kalariya-nikunj/Vishwakarma-Awards-KneeSense/media/photos/README.md

# Prototype photos

Photos are hosted in the project owner's [Google Drive media folder](https://drive.google.com/drive/folders/1JCOzSr-7obGCgrjGczuZRWfTyBF06cKV?usp=sharing).

Media stays in Drive rather than Git history. Folder contents and viewer access have not been verified. Check the link in a signed-out browser before sharing with judges; no sharing permissions were changed during repository setup. Add direct photo links and captions here when selected.
