kalariya-nikunj/Vishwakarma-Awards-KneeSense/hardware/KiCad/Prototype_KneeSense_V1/KneeSense_Bill_of_Materials-1.xlsx

Sheet: BOM
KneeSense — Bill of Materials (BOM)
Portable knee-movement assessment system | Estimated India retail prices (₹), checked Oct 2026; confirm before purchase
Item ID | Category | Component / Material | Specification / Part | Qty per Node | Qty for 2 Nodes | Unit | Purpose / Notes | Unit Cost (₹) | Total Cost (₹) | Supplier / Link | Status
KS-001 | Electronics | Microcontroller (MCU) | Seeed XIAO nRF52840 Sense | 1 | 2 | piece | Main MCU and Bluetooth Low Energy (BLE) communication | ₹2300.00 |  |  | Selected in project deck
KS-002 | Electronics | IMU Sensor | Integrated 6-axis IMU (accelerometer + gyroscope) | 1 | 2 | piece | Movement sensing; the deck also lists magnetometer in the BOM description | ₹0.00 |  |  | Selected in project deck
KS-003 | Electronics | Micro SD Card Module | Micro SD module | 1 | 2 | piece | Local data storage / gait data | ₹89.00 |  |  | Listed in project deck
KS-004 | Electronics | Button (Tactile Switch) | Momentary push button | 1 | 2 | piece | User input / start-stop recording | ₹4.00 |  |  | Listed in project deck
KS-005 | Power | Battery | Li-Po, 3.7 V, approximately 500 mAh | 1 | 2 | piece | Portable power supply | ₹177.00 |  |  | Listed in project deck
KS-006 | Power | Voltage Regulator | 3.3 V input/output; optional | 1 | 2 | piece | Stable power for MCU and sensors; confirm whether needed for selected battery/board | ₹40.00 |  |  | Optional / verify
KS-007 | Connections | Connectors / Headers | Pin headers, JST connectors as required |  |  | lot | Sensor and battery connections; quantities depend on PCB layout | ₹100.00 | ₹100.00 |  | As required
KS-008 | Support | Miscellaneous Electronics | Resistors, capacitors, LEDs (optional) |  |  | lot | Supporting circuitry and indicators | ₹100.00 | ₹100.00 |  | Optional / as required
 |  |  |  |  |  |  |  | Estimated Total
Quantity note: | The project deck describes two wearable IMU nodes (thigh + shank). Qty for 2 nodes is calculated for fixed per-node quantities; items marked 'as required' need final PCB/wiring confirmation.

Sheet: Fabrication
KneeSense — Fabrication & Assembly Materials
Materials listed on page 9 of the supplied project deck. Quantities and costs were not specified in the source.
Item ID | Item | Specification | Purpose | Estimated Quantity | Unit Cost (₹) | Notes
KS-F01 | Copper Plate / PCB | Custom PCB with copper layer | Circuit board fabrication |  | ₹250.00 | Budget estimate; PCB fabrication price depends on size and quantity
KS-F02 | Soldering Iron | Temperature-controlled; approximately 25–60 W | Soldering components |  | ₹500.00 | Approximate shared tool cost; exclude if already available
KS-F03 | Solder Wire | Lead-free solder wire, e.g. Sn-Ag-Cu | Electrical connections |  | ₹150.00 | Estimated solder wire spool
KS-F04 | Connecting Wire | Jumper wires / hookup wire | Interconnections between modules |  | ₹100.00 | Estimated jumper/hookup wire allowance
KS-F05 | Miscellaneous Fabrication Supplies | Flux, PCB drill (if needed), etc. | Supporting fabrication |  | ₹150.00 | Estimated consumables allowance
 |  |  |  | Estimated subtotal

Sheet: README
KneeSense BOM — README
Project | KneeSense — A Portable System for Knee-Movement Assessment and Longitudinal Monitoring Research
Application ID | VK26-IITI-HT-0186
Source file | Vishwakarma Round 2 (1).pdf, especially page 9: Electronics Schematics & Bill of Materials
Node configuration | Two wearable nodes: thigh IMU and shank IMU. The project deck selects Seeed XIAO nRF52840 Sense and targets BLE acquisition.
How to use | Enter the purchase price in the yellow Unit Cost cells on the BOM sheet. Total Cost is calculated automatically for rows with fixed quantities.
Quantity assumptions | Fixed quantities shown as per-node quantities from the source BOM; quantities for two nodes are calculated by multiplying by 2. Source did not specify quantities for connectors, headers, and miscellaneous components.
Cost assumptions | The supplied PDF does not state prices or supplier links. Cost and supplier fields are intentionally blank for you to fill using your actual purchases/quotes.
Verification needed | The source deck lists a separate 6-axis IMU sensor while the selected XIAO nRF52840 Sense has an integrated IMU. Confirm whether the separate sensor is needed before ordering to avoid duplicate purchasing.
Version control | Keep this file in the GitHub repository alongside the hardware design files. Update quantities and costs when the PCB design and final assembly are confirmed.
Price note | Prices are budgetary estimates in INR based on publicly listed India component prices checked in Oct 2026. Actual prices vary by seller, GST, shipping, quantity, and stock. The selected XIAO nRF52840 Sense includes an onboard 6-axis IMU, so the separate IMU row is priced at ₹0 pending confirmation; do not purchase a duplicate sensor unless the final design requires it.
