kalariya-nikunj/Vishwakarma-Awards-KneeSense/hardware/KiCad/Prototype_KneeSense_V1/3dmodels/4682 Micro SD Breakout.step

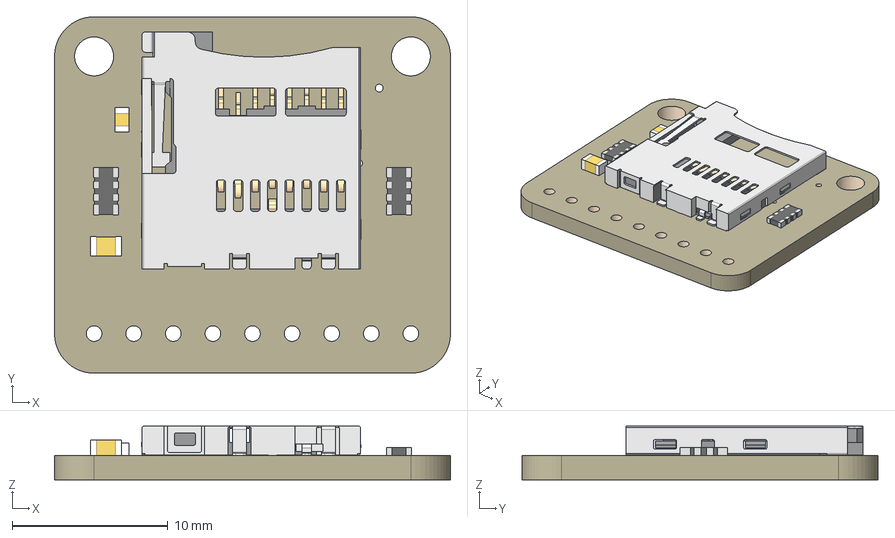
[picture p1: CAD file, 2026-10-25]
hardware/KiCad/Prototype_KneeSense_V1/3dmodels/4682 Micro SD Breakout.step
25.4 x 22.9 x 3.45 mm
Board
microSD
10uF
0.1uF
47K x 2
