kalariya-nikunj/Vishwakarma-Awards-KneeSense/mechanical/CAD/3D-Models/casing_V4.SLDPRT

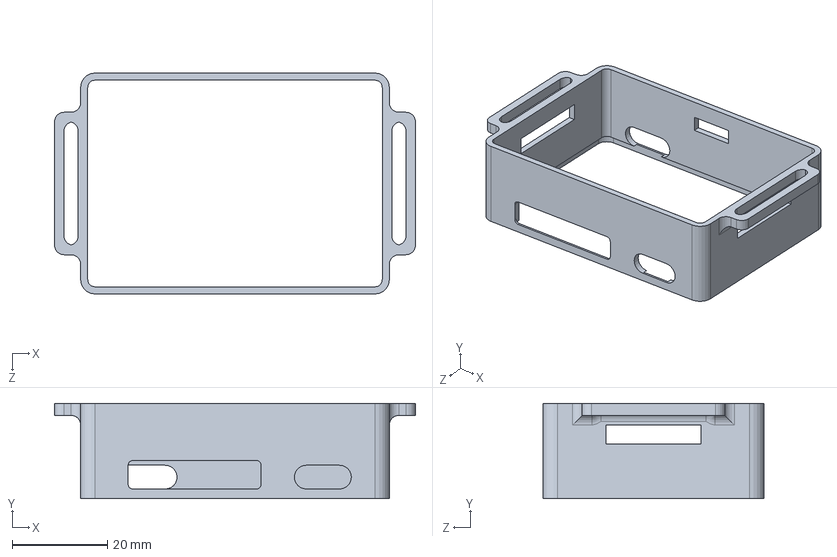
[picture p2: CAD file, 2026-10-25]
mechanical/CAD/3D-Models/casing_V4.SLDPRT
76.0 x 20.0 x 46.5 mm
