kalariya-nikunj/Vishwakarma-Awards-KneeSense/mechanical/CAD/3D-Models/bottom plate_V5.SLDPRT

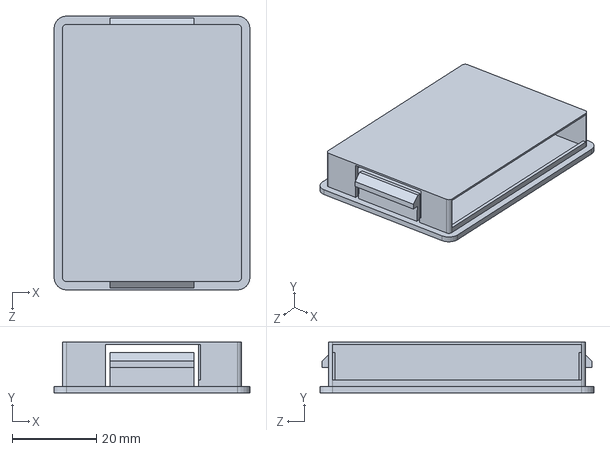
[picture p3: CAD file, 2026-10-25]
mechanical/CAD/3D-Models/bottom plate_V5.SLDPRT
46.5 x 12.0 x 65.0 mm
