kalariya-nikunj/Vishwakarma-Awards-KneeSense/mechanical/CAD/3D-Models/Assem2.SLDASM

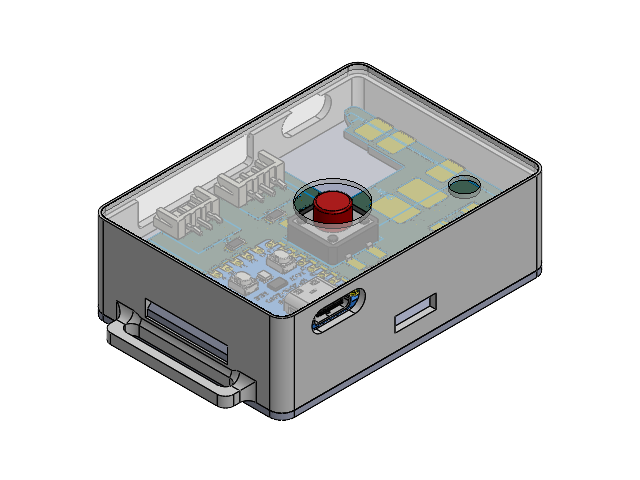
[picture p4: CAD file, 2026-10-25]
mechanical/CAD/3D-Models/Assem2.SLDASM
bottom plate_V5
casing_V4
Tactal Switch - THRU(12mmx12mmx8mm)-Red.step
RP2040-ZERO-WAVESHARE without headers.step
JST_EH_B3B-EH-A_1x03_P2.50mm_Vertical.step
R_1206_3216Metric.step x 4
JST_EH_B3B-EH-A_1x03_P2.50mm_Vertical-0.step
PCB_copper.step
PCB_silkscreen.step
PCB_soldermask.step
PCB_PCB.step
Part1^Assem2
