kalariya-nikunj/Vishwakarma-Awards-KneeSense/hardware/KiCad/Prototype_KneeSense_V1/Prototype_KneeSense_V1.kicad_pcb

## KiCad design hardware/KiCad/Prototype_KneeSense_V1/Prototype_KneeSense_V1.kicad_pcb (2026-10-25)

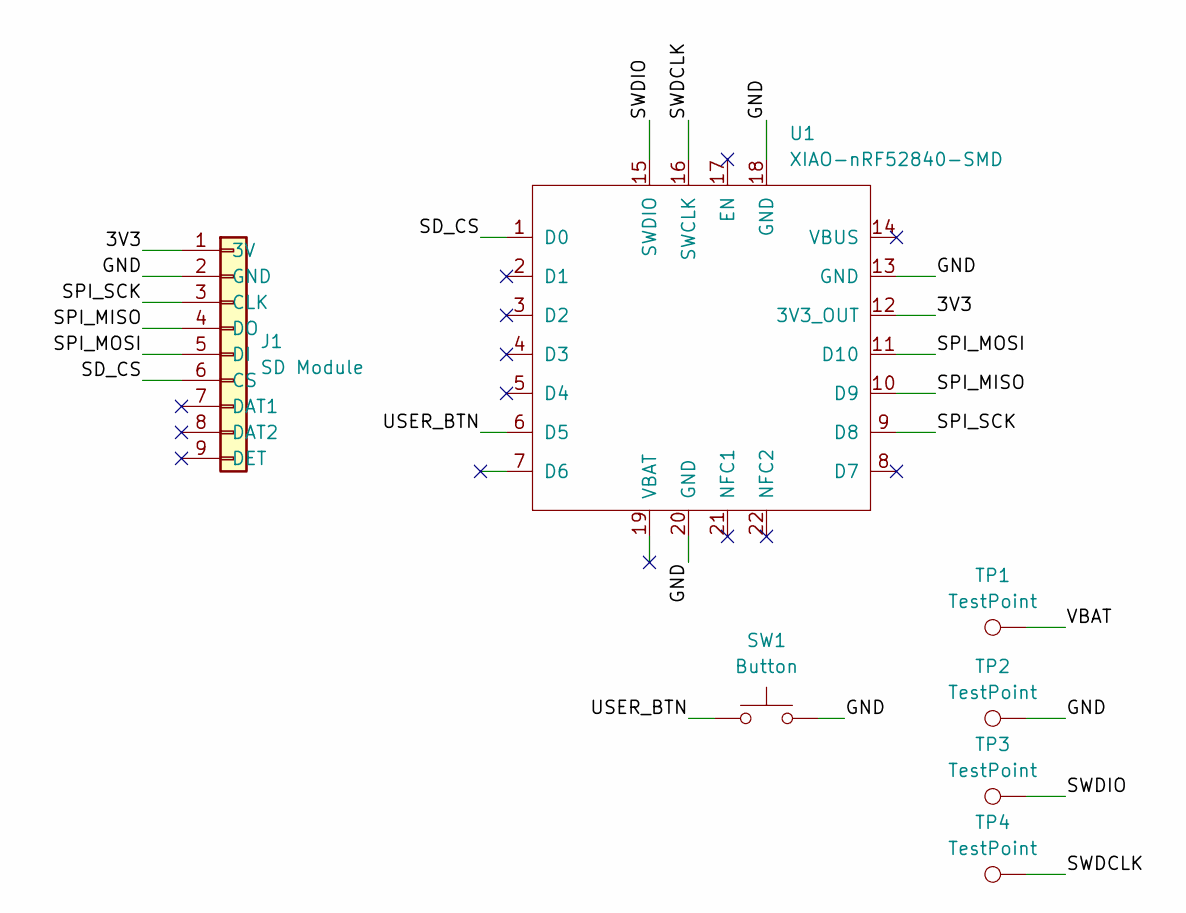
[picture p5: schematic Prototype_KneeSense_V1.kicad_sch]

Parts:
J1: SD Module; microSD_4682
SW1: Button; SW_SPST_PTS645Sx43SMTR92
TP1, TP2, TP3, TP4: TestPoint; TestPoint_Pad_4.0x4.0mm
U1: XIAO-nRF52840-SMD

Connections:
/3V3: J1.1 (3V), U1.12 (3V3_OUT)
/GND: J1.2 (GND), SW1.2 (GND), TP2.1 (1_1), U1.13 (GND), U1.18 (GND), U1.20 (GND)
/SD_CS: J1.6 (CS), U1.1 (D0)
/SPI_MISO: J1.4 (DO), U1.10 (D9)
/SPI_MOSI: J1.5 (DI), U1.11 (D10)
/SPI_SCK: J1.3 (CLK), U1.9 (D8)
/SWDCLK: TP4.1 (1_1), U1.16 (SWCLK)
/SWDIO: TP3.1 (1_1), U1.15 (SWDIO)
/USER_BTN: SW1.1 (USER_BTN), U1.6 (D5)
/VBAT: TP1.1 (1_1)

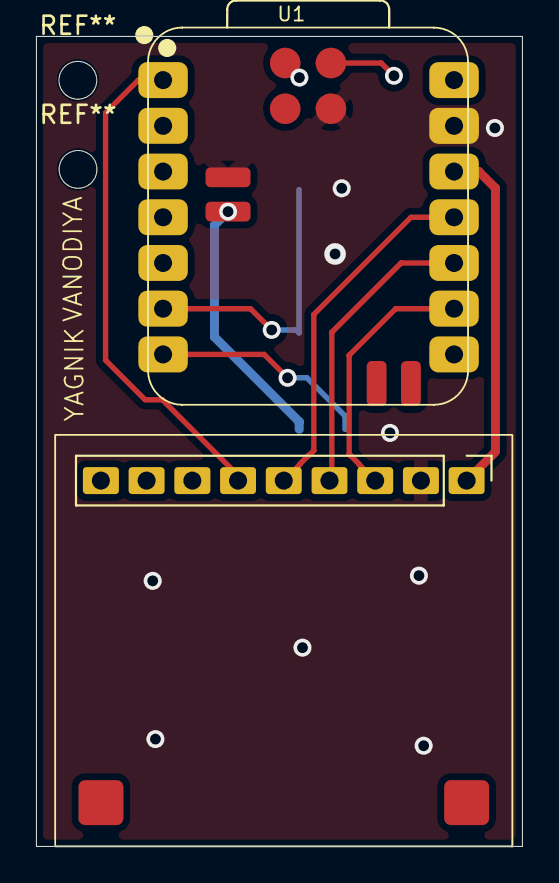
[picture p6: board Prototype_KneeSense_V1.kicad_pcb from above]

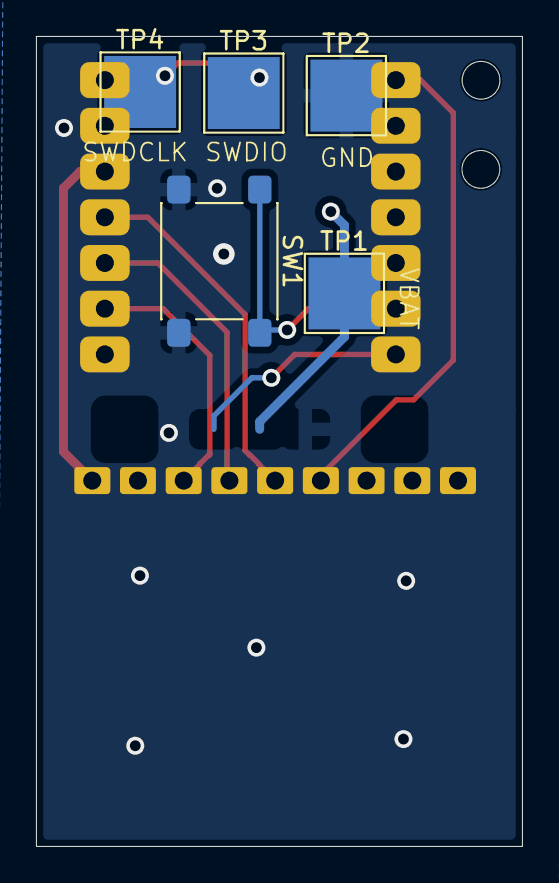
[picture p7: board Prototype_KneeSense_V1.kicad_pcb from below]

Board: 2 copper layers, 27.0 x 45.0 mm, 7 parts (5 on the bottom side), 9 nets.
