kalariya-nikunj/Vishwakarma-Awards-KneeSense/hardware/KiCad/Prototype_KneeSense_V1/Adafruit-MicroSD-SPI-or-SDIO-card-breakout-PCB-master/Adafruit SDIO microSD.brd

## EAGLE design hardware/KiCad/Prototype_KneeSense_V1/Adafruit-MicroSD-SPI-or-SDIO-card-breakout-PCB-master/Adafruit SDIO microSD.brd (2026-10-25)

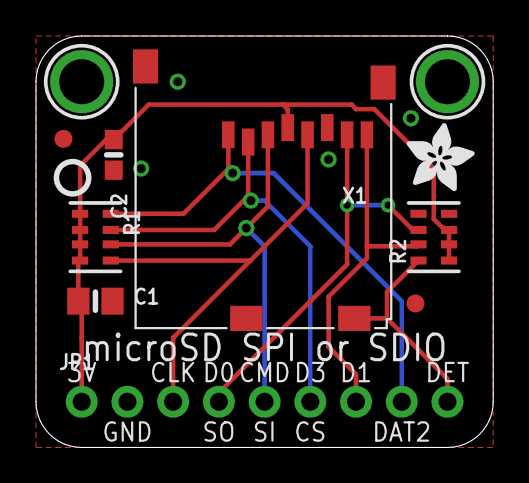
[picture p8: board Adafruit SDIO microSD.brd from above]

Board: 2 copper layers, 25.4 x 22.9 mm, 12 parts (0 on the bottom side), 9 nets.

Parts:
C1: 10uF; 0805-NO
C2: 0.1uF; 0603-NO
FID1, FID2: FIDUCIAL""; FIDUCIAL_1MM
JP1: 1X09_ROUND_70
R1, R2: 47K; RESPACK_4X0603
U$1, U$2: MOUNTINGHOLE2.5; MOUNTINGHOLE_2.5_PLATED
U$4: ADAFRUIT_3.5MM
U$7: PCBFEAT-REV-040
X1: microSD; MICROSD

Connections:
3.3V: C1.1, C2.1, JP1.1, R1.1, R1.2, R1.3, R1.4, R2.1, R2.2, R2.3, X1.4
CARDDET: JP1.9, R2.8, X1.CD1
CS: JP1.6, R1.7, X1.2
DAT1: JP1.7, R2.7, X1.8
DAT2: JP1.8, R1.8, X1.1
DI: JP1.5, R1.6, X1.3
DO: JP1.4, R2.6, X1.7
GND: C1.2, C2.2, JP1.2, X1.6, X1.MT1, X1.MT2
SCLK: JP1.3, R1.5, X1.5
