kalariya-nikunj/Vishwakarma-Awards-KneeSense/results/graphs/kneesense_20261024_145548.png

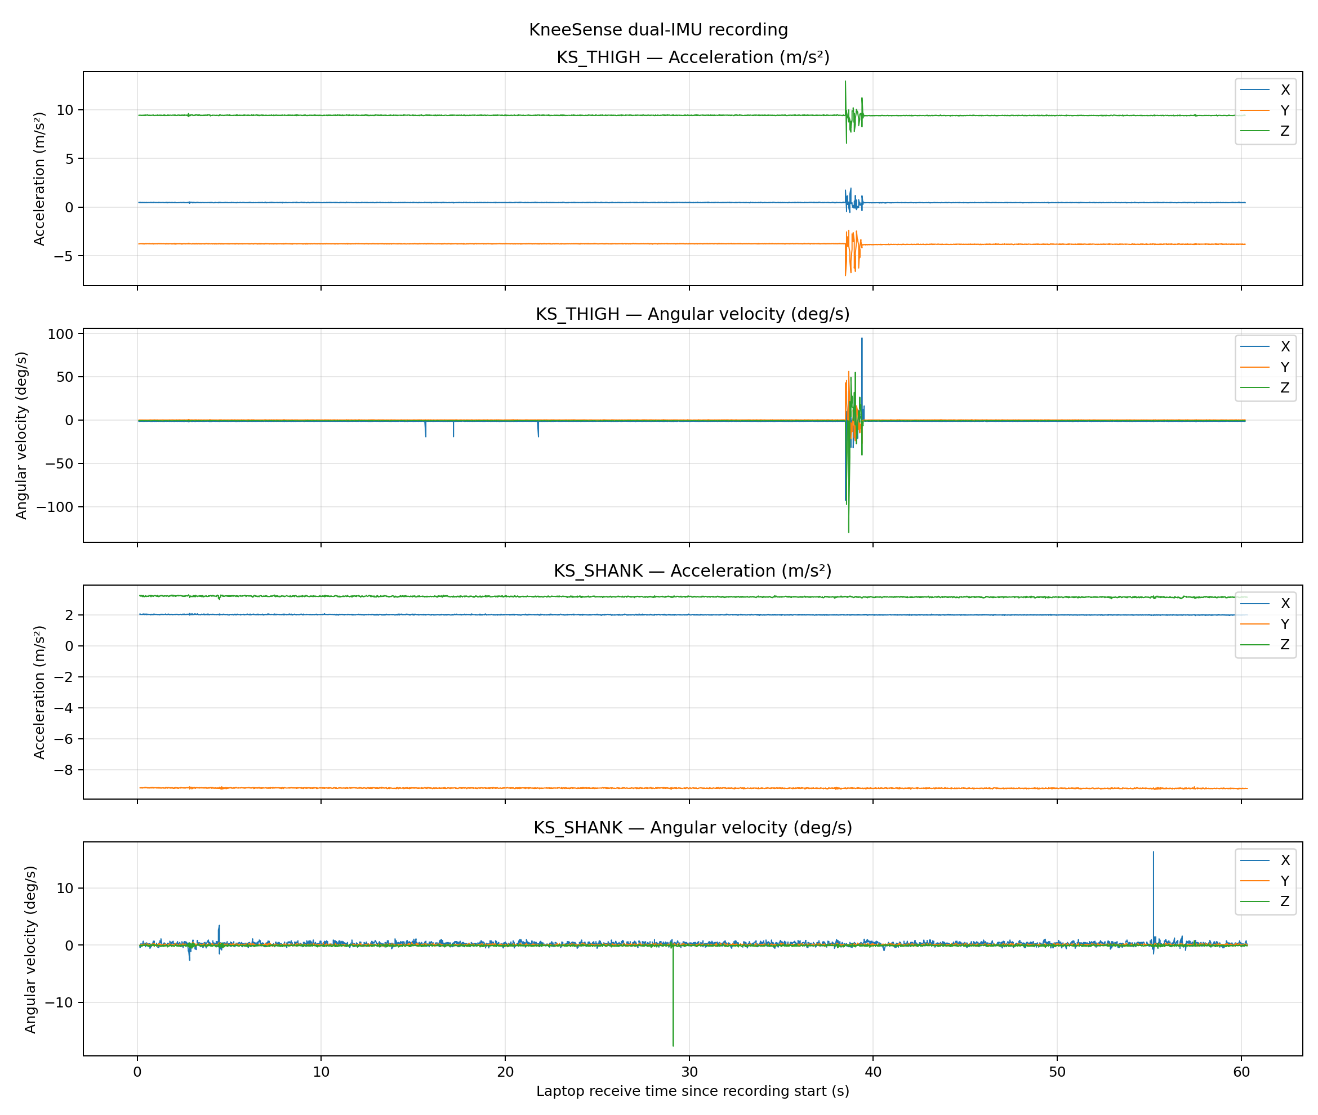
results/graphs/kneesense_20261024_145548.png
