kalariya-nikunj/Vishwakarma-Awards-KneeSense/results/graphs/kneesense_20261024_150110.png

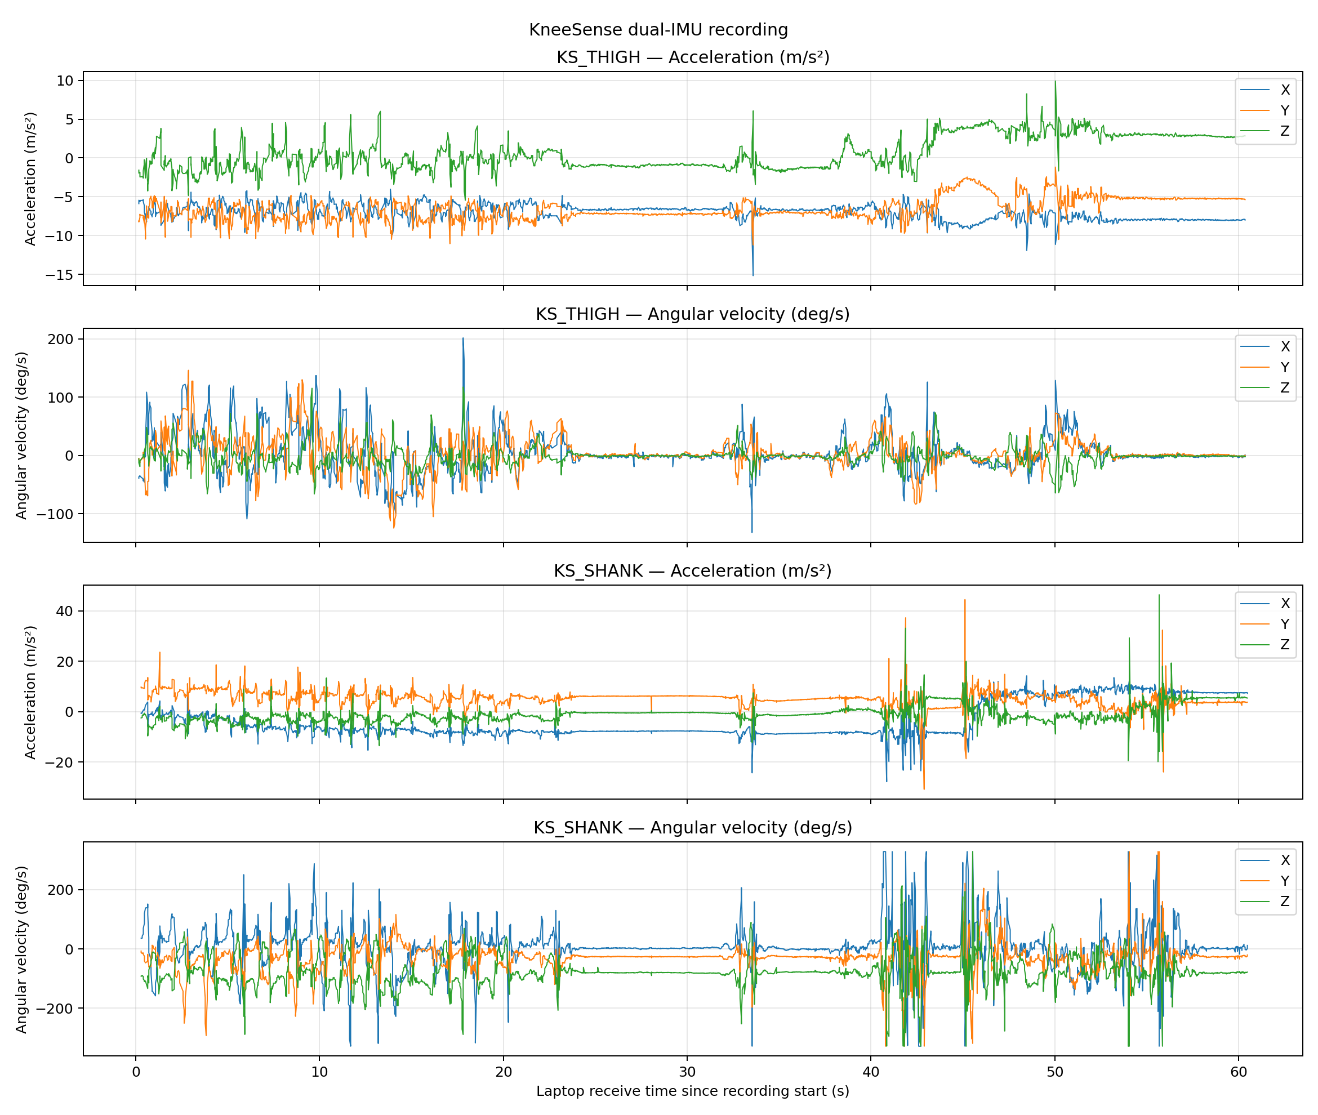
results/graphs/kneesense_20261024_150110.png
