kalariya-nikunj/Vishwakarma-Awards-KneeSense/results/graphs/kneesense_20261024_151926.png

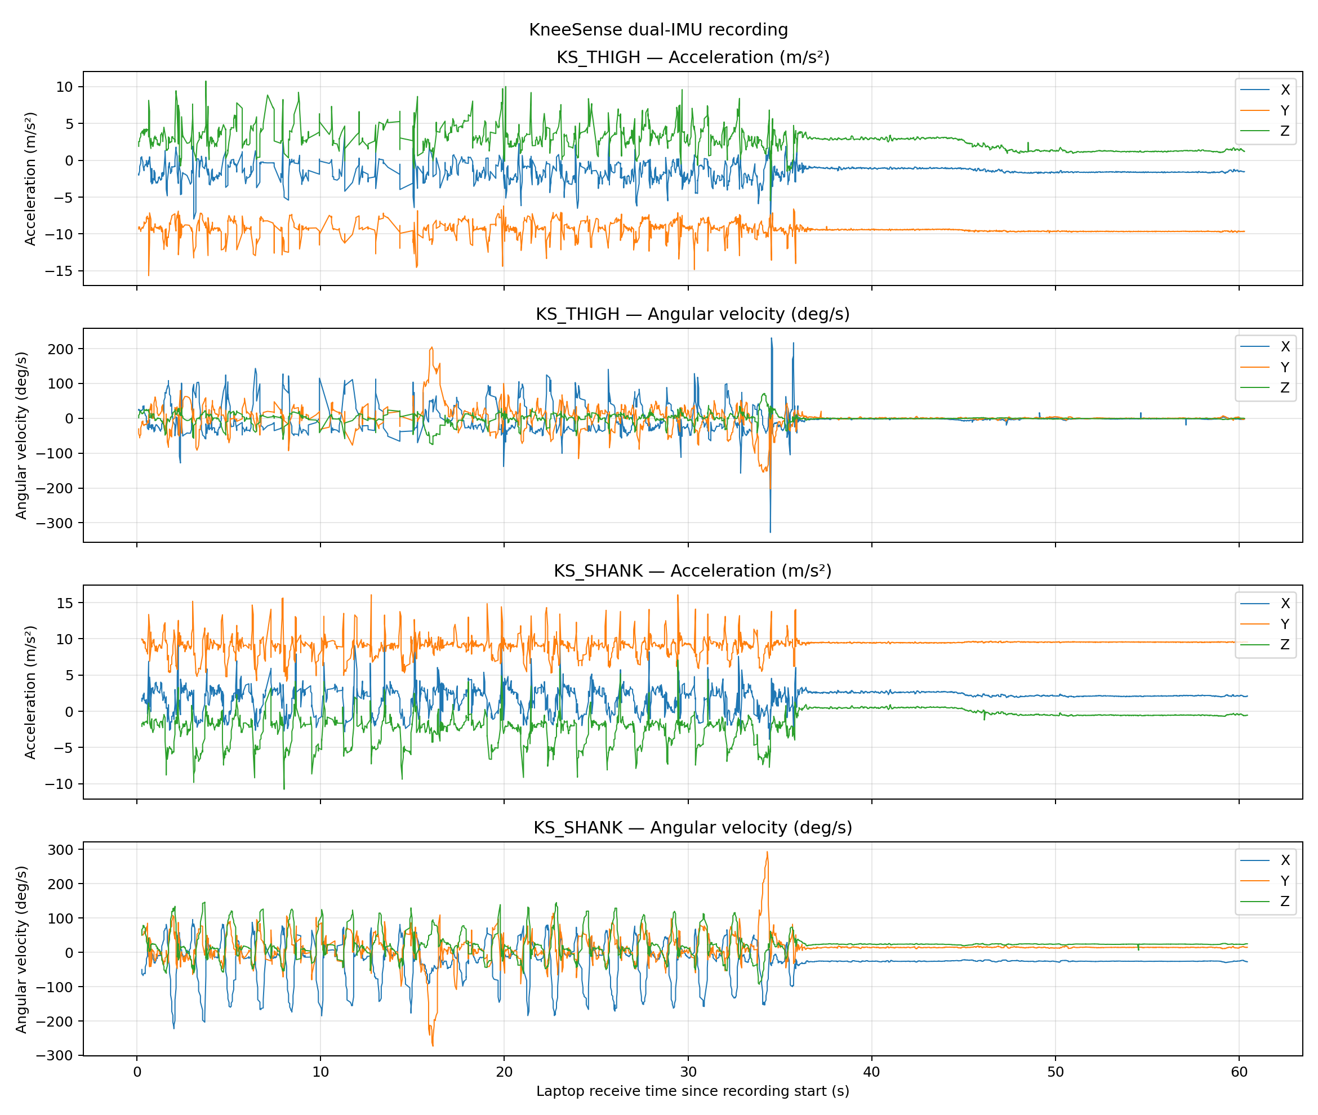
results/graphs/kneesense_20261024_151926.png
