kalariya-nikunj/Vishwakarma-Awards-KneeSense/(commit log)

2026-10-24 Track empty project folders
2026-10-25 Organize KneeSense prototype files and documentation
2026-10-25 Add KneeSense source, designs, recordings and Drive media links
    [4682 Micro SD Breakout.step, Adafruit SDIO microSD.brd, Adafruit SDIO microSD.sch, Assem2.SLDASM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]
2026-10-25 Add BOm
    [KneeSense_Bill_of_Materials-1.xlsx]
